ardhimaulidani/wearable_controller/hardware/wearable_v4.brd

## EAGLE design hardware/wearable_v4.brd (2024-03-16)

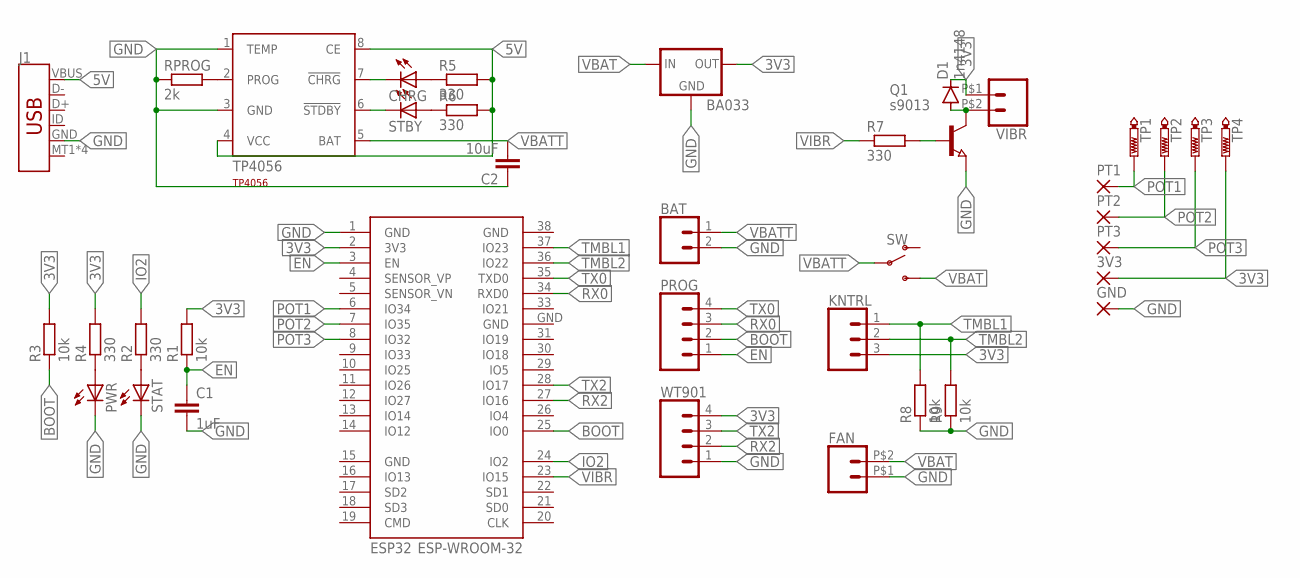
[picture p1: schematic wearable_v4.sch]

Parts:
3V3: WIREPADSMD1,27-254; SMD1,27-2,54
BA033: V_REG_78XX7812; TO-252
BAT: CONN_02-JST-2MM-SMT; JST-2-SMD
C1: 1uF; C0805
C2: 10uF; C0805
CHRG: LEDCHIPLED_0805; CHIPLED_0805
D1: 1n4148; SOD80C
ESP32: ESP-WROOM-32
FAN: SOLDER_PAD_2
GND: WIREPADSMD1,27-254; SMD1,27-2,54
J1: USB_MICRO-B_SMT; USB-MICROB
KNTRL: 3-PIN SMD; JST-3-SMD
PROG: CONN_04JST-SMD; JST-4-SMD
PT1, PT2, PT3: WIREPADSMD1,27-254; SMD1,27-2,54
PWR: LEDCHIPLED_0805; CHIPLED_0805
Q1: s9013; SOT23
R1, R3, R8, R9: 10k; R0805
R2, R4, R5, R6, R7: 330; R0805
RPROG: 2k; R0805
STAT: LEDCHIPLED_0805; CHIPLED_0805
STBY: LEDCHIPLED_0805; CHIPLED_0805
SW: SWITCH-SPDT-SMD-RIGHT-ANGLE; SWITCH_SPST_SMD_A
TP1, TP2, TP3, TP4: PTR1TP09R; TP09R
TP4056: TP4056; SOT23-8
VIBR: SOLDER_PAD_2
WT901: CONN_04JST-SMD; JST-4-SMD

Connections:
3V3: 3V3.1, BA033.2 (OUT), D1.C, ESP32.2 (3V3), KNTRL.3 (1), R1.2, R3.2, R4.2, TP4.TP, VIBR.P$1 (1), WT901.4
5V: J1.VBUS, R5.2, R6.2, TP4056.4 (VCC), TP4056.8 (CE)
BOOT: ESP32.25 (IO0), PROG.2, R3.1
EN: C1.1, ESP32.3 (EN), PROG.1, R1.1
GND: BA033.3 (GND), BAT.2 (1), C1.2, C2.1, ESP32.1 (GND), ESP32.15 (GND), ESP32.38 (GND), ESP32.GND, FAN.P$1 (1), GND.1, J1.GND, PWR.C, Q1.2 (E), R8.1, R9.1, RPROG.1, STAT.C, TP4056.1 (TEMP), TP4056.3 (GND), WT901.1
IO2: ESP32.24 (IO2), R2.2
unnamed: R2.1, STAT.A
unnamed: PWR.A, R4.1
unnamed: CHRG.A, R5.1
unnamed: R6.1, STBY.A
unnamed: CHRG.C, TP4056.7 (!CHRG)
unnamed: STBY.C, TP4056.6 (!STDBY)
unnamed: RPROG.2, TP4056.2 (PROG)
unnamed: Q1.1 (B), R7.2
unnamed: D1.A, Q1.3 (C), VIBR.P$2 (2)
POT1: ESP32.6 (IO34), PT1.1, TP1.TP
POT2: ESP32.7 (IO35), PT2.1, TP2.TP
POT3: ESP32.8 (IO32), PT3.1, TP3.TP
RX0: ESP32.34 (RXD0), PROG.3
RX2: ESP32.27 (IO16), WT901.2
TMBL1: ESP32.37 (IO23), KNTRL.1 (3), R8.2
TMBL2: ESP32.36 (IO22), KNTRL.2, R9.2
TX0: ESP32.35 (TXD0), PROG.4
TX2: ESP32.28 (IO17), WT901.3
VBAT: BA033.1 (IN), FAN.P$2 (2), SW.3 (S)
VBATT: BAT.1 (2), C2.2, SW.2, TP4056.5 (BAT)
VIBR: ESP32.23 (IO15), R7.1

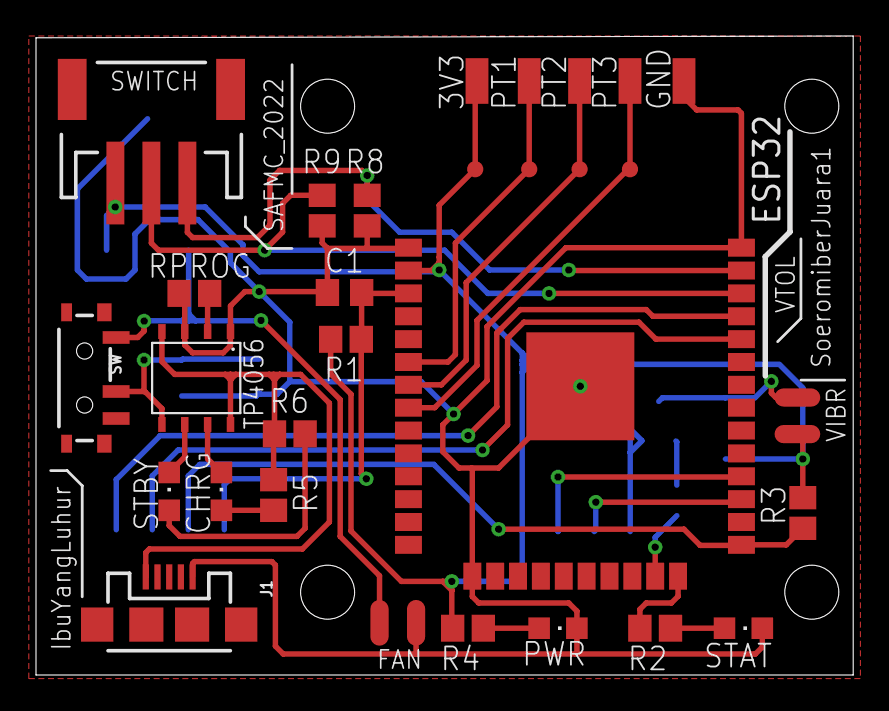
[picture p2: board wearable_v4.brd from above]

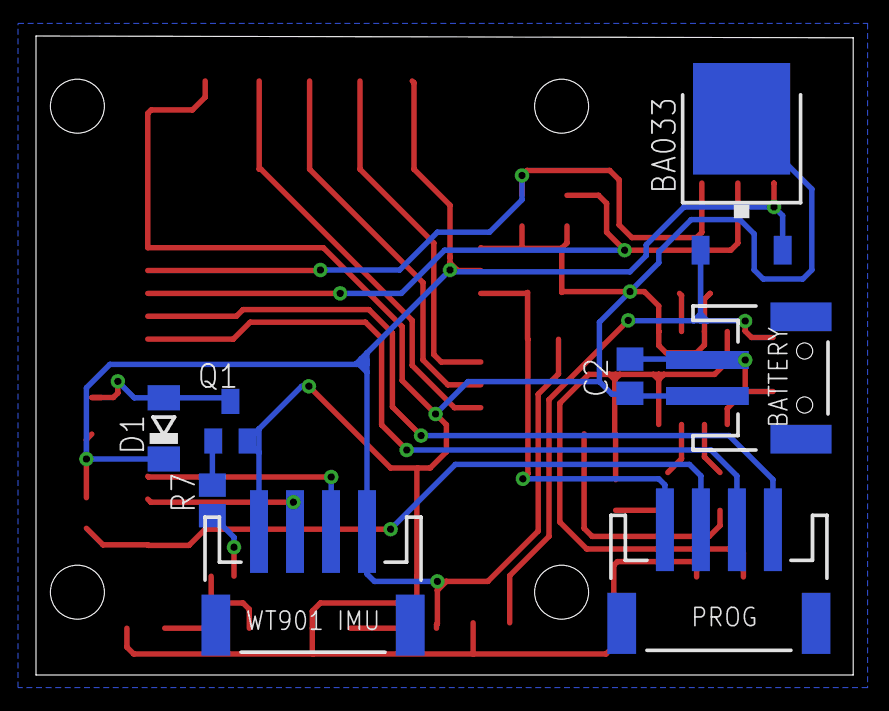
[picture p3: board wearable_v4.brd from below]

Board: 2 copper layers, 45.4 x 35.5 mm, 38 parts (8 on the bottom side), 27 nets.
