ardhimaulidani/wearable_controller/hardware/wearable_button.brd

## EAGLE design hardware/wearable_button.brd (2024-03-16)

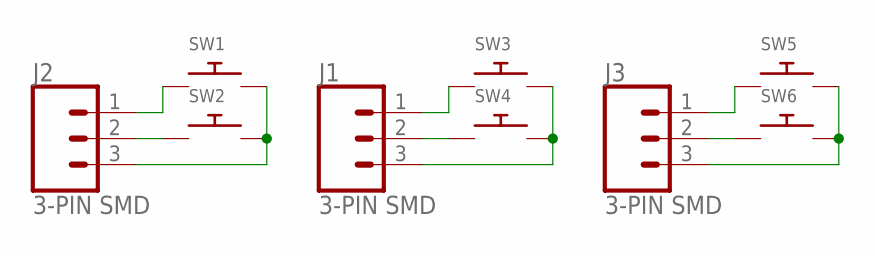
[picture p4: schematic wearable_button.sch]

Parts:
J1, J2, J3: 3-PIN SMD; JST-3-SMD
SW1, SW2, SW3, SW4, SW5, SW6: SWITCH_PUSHBUTTONSOFTTOUCHSMD_SJ; PUSHBUTTON_SMD_SJ

Connections:
unnamed: J2.2, SW2.P$1
unnamed: J2.1 (3), SW1.P$1
unnamed: J1.1 (3), SW3.P$1
unnamed: J1.2, SW4.P$1
unnamed: J2.3 (1), SW1.P$2, SW2.P$2
unnamed: J1.3 (1), SW3.P$2, SW4.P$2
unnamed: J3.3 (1), SW5.P$2, SW6.P$2
unnamed: J3.1 (3), SW5.P$1
unnamed: J3.2, SW6.P$1

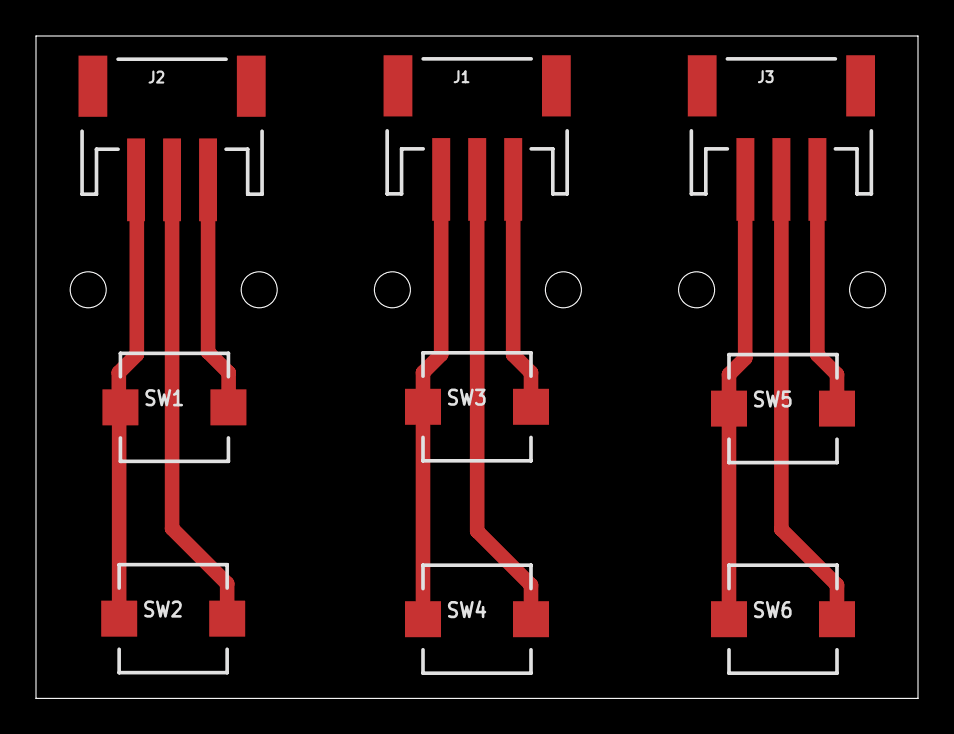
[picture p5: board wearable_button.brd from above]

Board: 2 copper layers, 49.0 x 36.8 mm, 9 parts (0 on the bottom side), 9 nets.
