ardhimaulidani/wearable_controller/hardware/WT901.brd

## EAGLE design hardware/WT901.brd (2024-03-16)

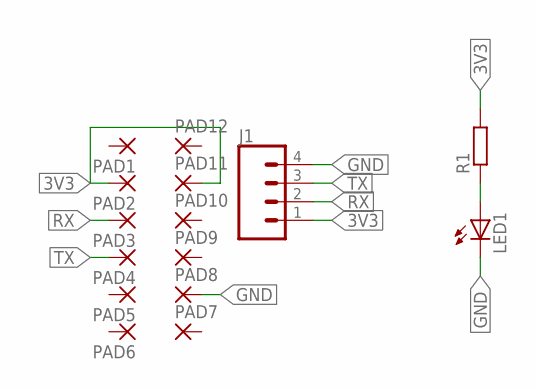
[picture p6: schematic WT901.sch]

Parts:
J1: CONN_04JST-SMD; JST-4-SMD
LED1: LEDCHIPLED_0805; CHIPLED_0805
PAD1, PAD2, PAD3, PAD4, PAD5, PAD6, PAD7, PAD8, PAD9, PAD10, PAD11, PAD12: SMD2; SMD1,27-2,54
R1: R-EU_R0805; R0805

Connections:
3V3: J1.1, PAD2.1, PAD11.1, R1.2
GND: J1.4, LED1.C, PAD8.1
unnamed: LED1.A, R1.1
RX: J1.2, PAD3.1
TX: J1.3, PAD4.1

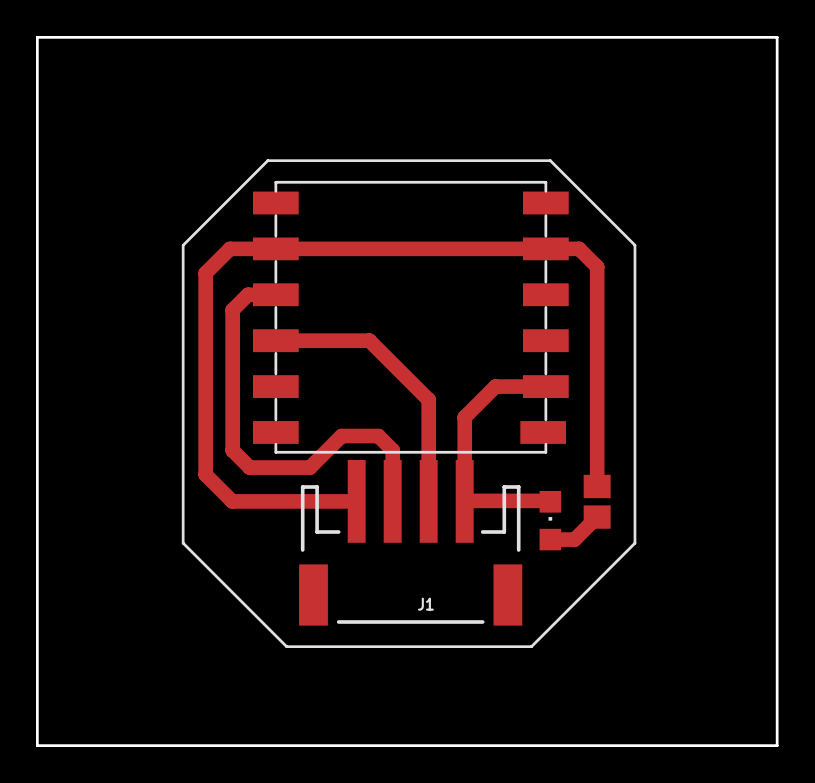
[picture p7: board WT901.brd from above]

Board: 2 copper layers, 41.1 x 39.4 mm, 15 parts (0 on the bottom side), 5 nets.
