ardhimaulidani/wearable_controller/components/adc_wearable/adc_wearable.c

#include "adc_wearable.h"

#define DEFAULT_VREF    1100
#define NO_OF_SAMPLES   1

static esp_adc_cal_characteristics_t *adc_chars;

static void check_efuse()
{
    if (esp_adc_cal_check_efuse(ESP_ADC_CAL_VAL_EFUSE_VREF) == ESP_OK) {
        printf("eFuse Vref: Supported\n");
    } else {
        printf("eFuse Vref: NOT supported\n");
    }
}

static void print_char_val_type(esp_adc_cal_value_t val_type)
{
    if (val_type == ESP_ADC_CAL_VAL_EFUSE_TP) {
        printf("Characterized using Two Point Value\n");
    } else if (val_type == ESP_ADC_CAL_VAL_EFUSE_VREF) {
        printf("Characterized using eFuse Vref\n");
    } else {
        printf("Characterized using Default Vref\n");
    }
}

void adc_config(adc_channel_t channel, adc_atten_t atten, adc_unit_t unit)
{
    //Configure ADC
    if (unit == ADC_UNIT_1) {
        adc1_config_width(ADC_WIDTH_BIT_12);
        adc1_config_channel_atten(channel, atten);
    } else {
        adc2_config_channel_atten((adc2_channel_t)channel, atten);
    }

    //Characterize ADC
    adc_chars = calloc(1, sizeof(esp_adc_cal_characteristics_t));
    esp_adc_cal_value_t val_type = esp_adc_cal_characterize(unit, atten, ADC_WIDTH_BIT_12, DEFAULT_VREF, adc_chars);
}

uint16_t adc_main(adc_channel_t channel, adc_unit_t unit)
{
    uint16_t adc_reading = 0;
    //Multisampling
    for (short i = 0; i < NO_OF_SAMPLES; i++) {
        if (unit == ADC_UNIT_1) {
            adc_reading += adc1_get_raw((adc1_channel_t)channel);
        } else {
            int raw;
            adc2_get_raw((adc2_channel_t)channel, ADC_WIDTH_BIT_12, &raw);
            adc_reading += raw;
        }
    }
    adc_reading /= NO_OF_SAMPLES;
    //Convert adc_reading to voltage in mV
    //uint32_t voltage = esp_adc_cal_raw_to_voltage(adc_reading, adc_chars);
    //printf("Raw: %d\tVoltage: %dmV\n", adc_reading, voltage);
    return adc_reading;
}
