ardhimaulidani/wearable_controller/(notices)

Notices in the files:
parts and their libraries:
SparkFun-Connectors: Licensing: Creative Commons ShareAlike 4.0 International - https://creativecommons.org/licenses/by-sa/4.0
esp32: Creative Commons Attribution-ShareAlike 4.0 International
